TheDuckFrederik/Trafik/SCR-20260928-qmtm.jpeg

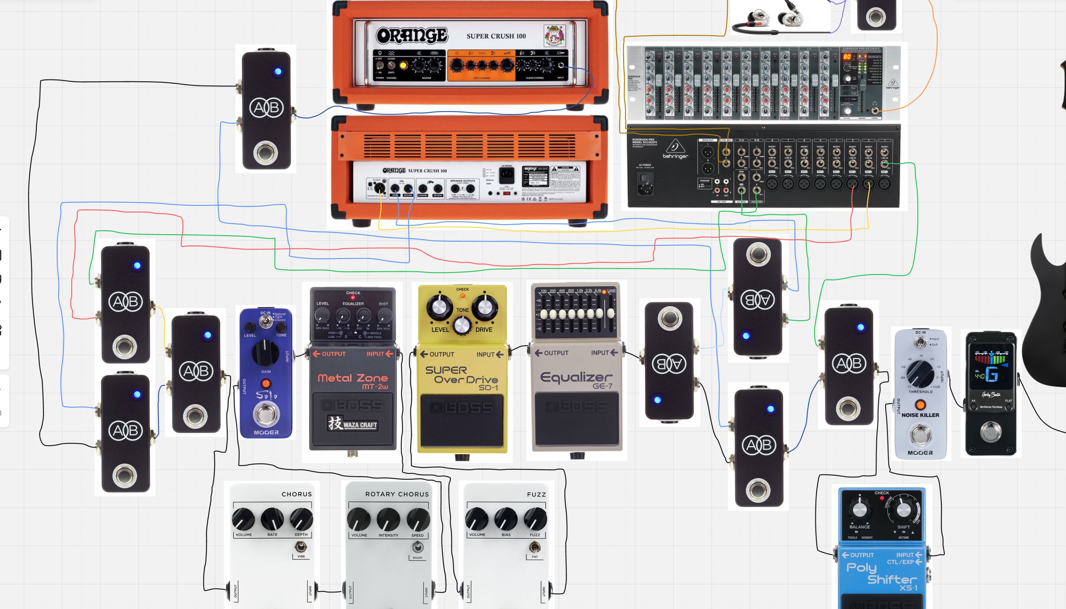
SCR-20260928-qmtm.jpeg
