TheDuckFrederik/Trafik/SCR-20260928-qmrf.jpeg

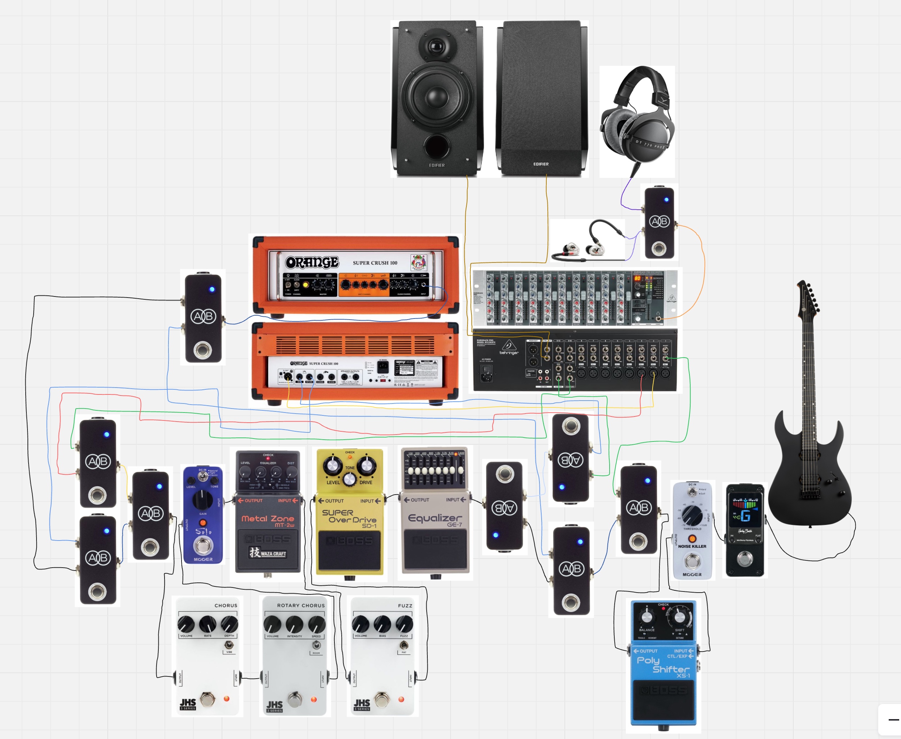
SCR-20260928-qmrf.jpeg
