TheDuckFrederik/Trafik/SingleLane/SingleLane.kicad_sch

## KiCad design SingleLane/SingleLane.kicad_sch (2026-10-13)

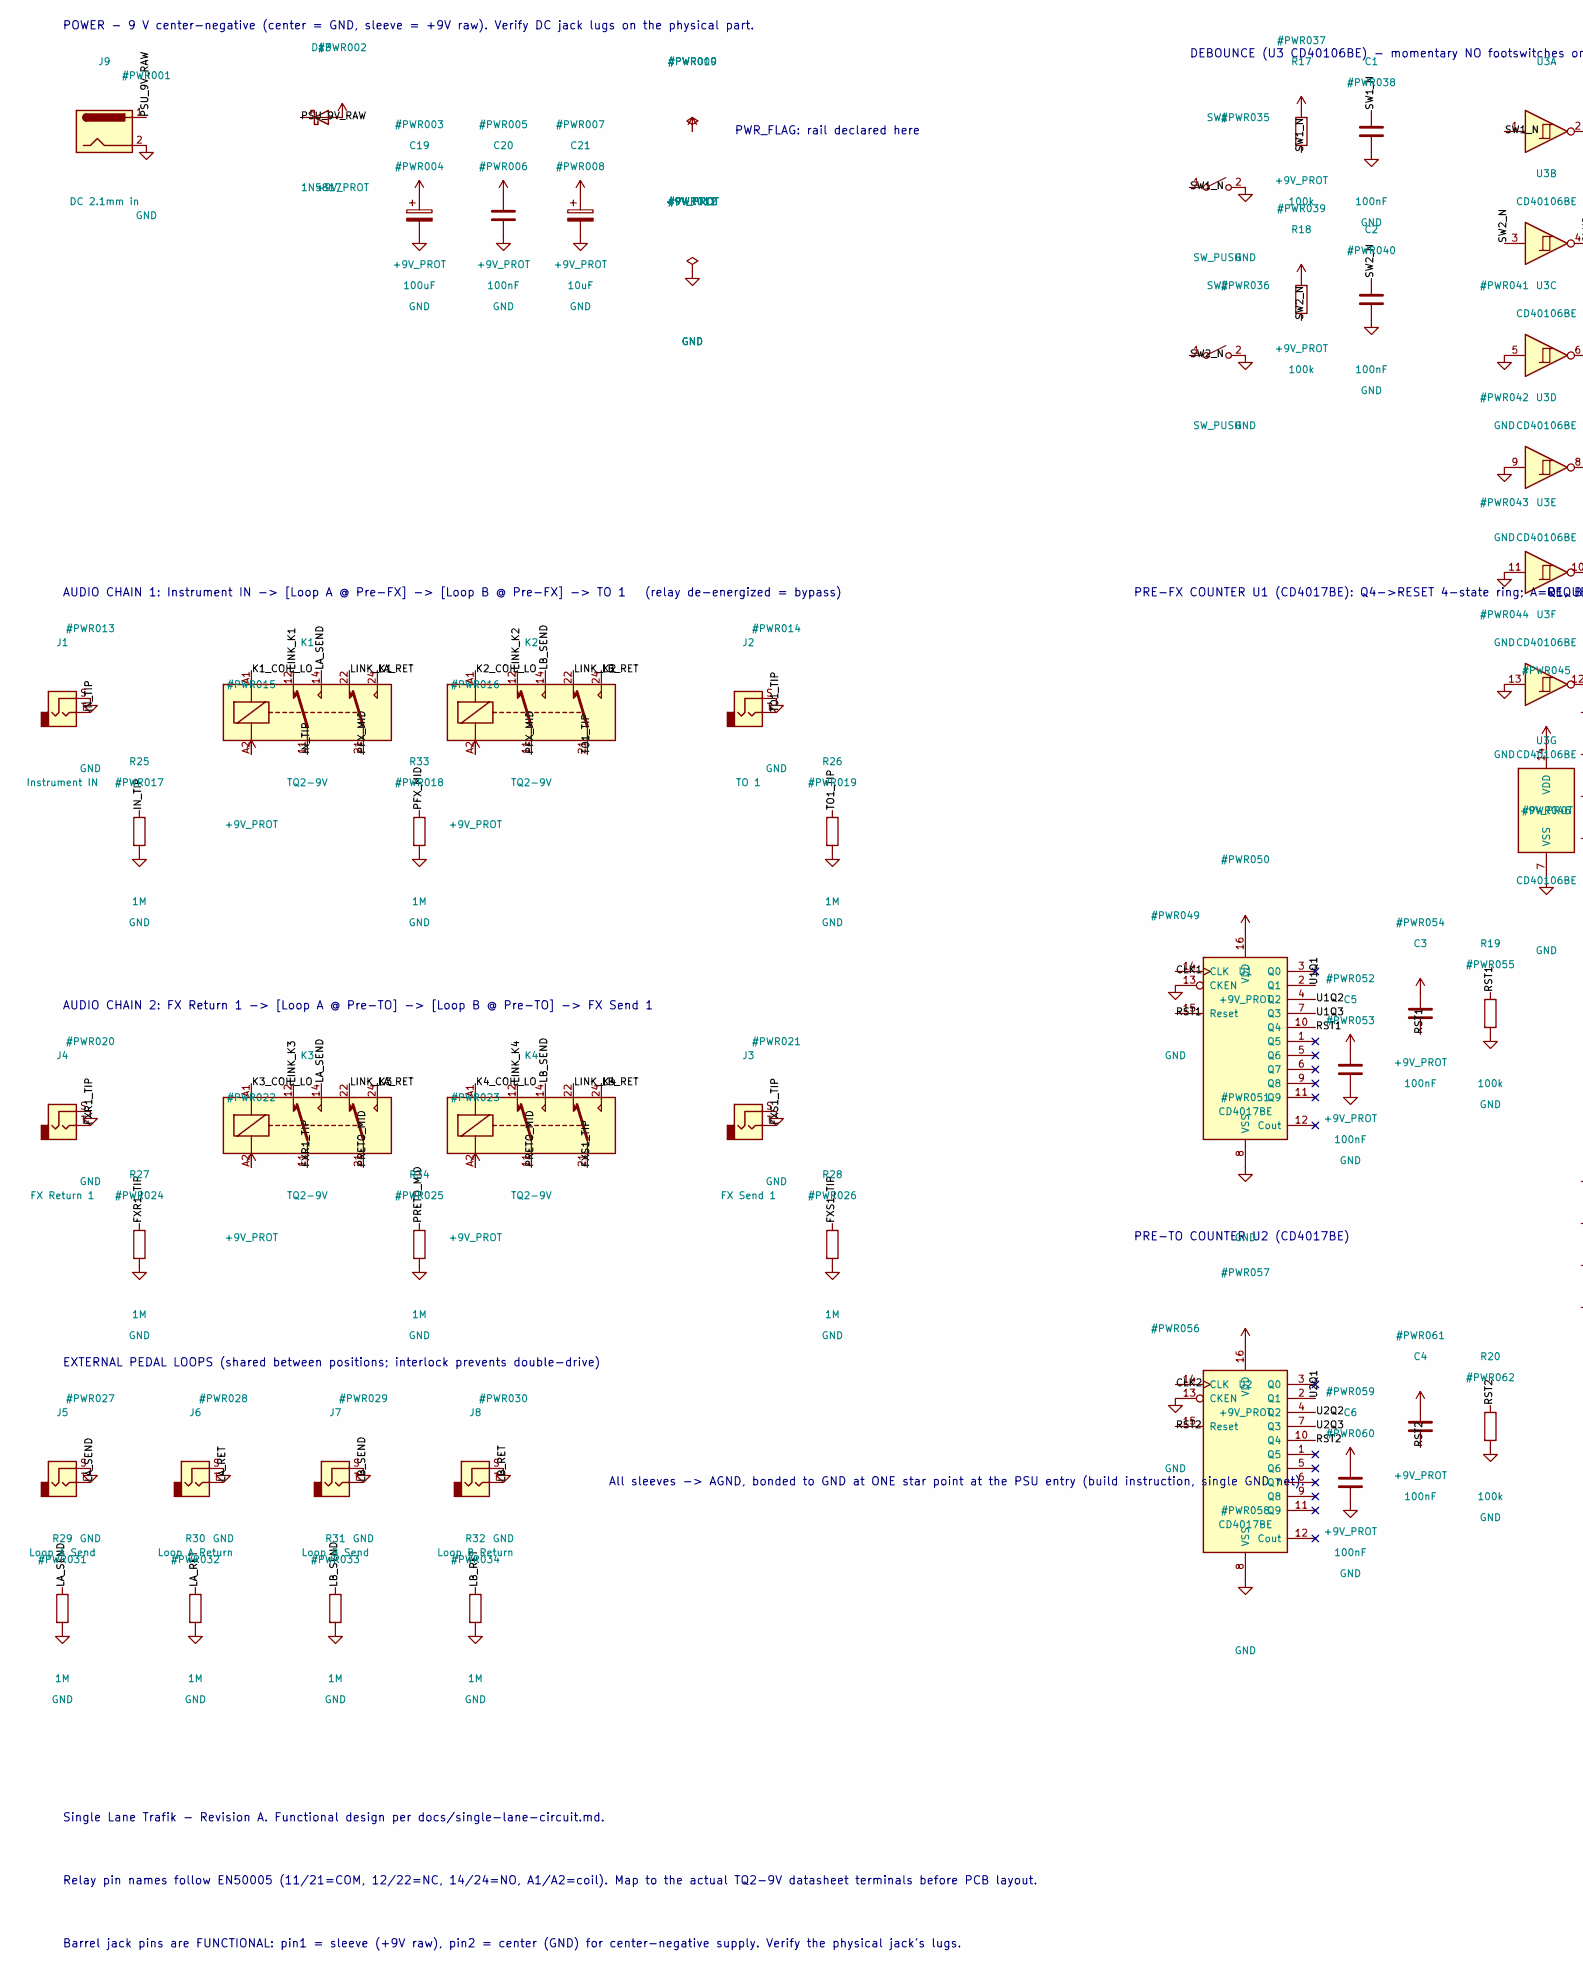
[picture p3: schematic SingleLane.kicad_sch, part in row 1, column 1]

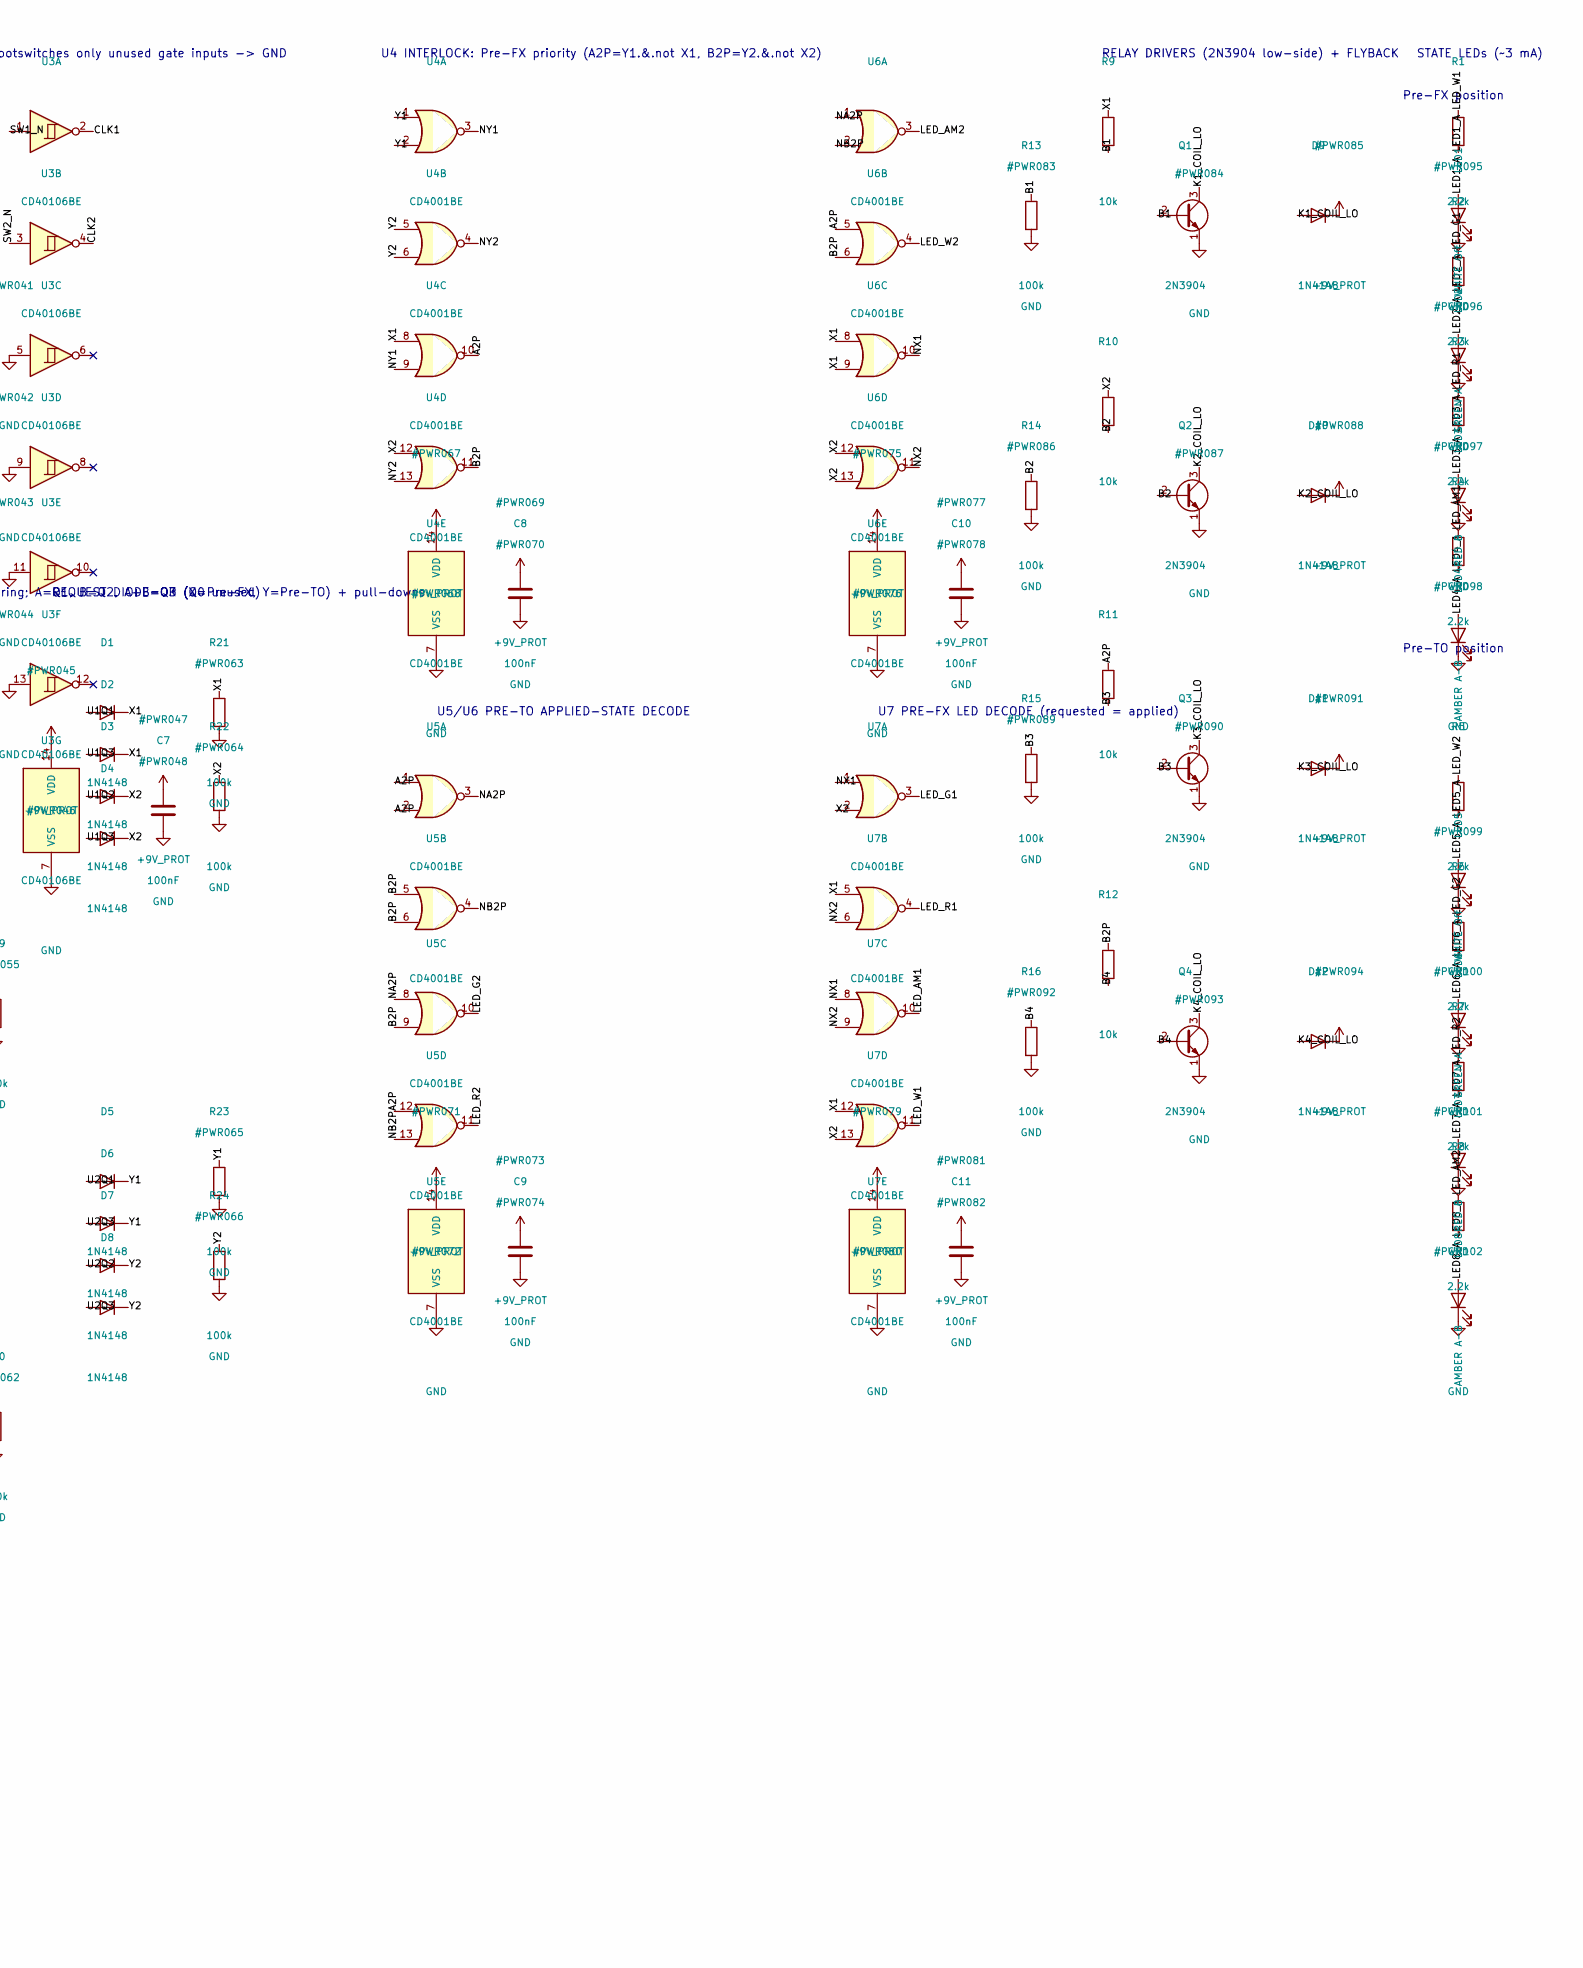
[picture p4: schematic SingleLane.kicad_sch, part in row 1, column 2]

Parts:
C1, C2, C3, C4, C5, C6, C7, C8, C9, C10, C11, C20: 100nF
C19: 100uF
C21: 10uF
D1, D2, D3, D4, D5, D6, D7, D8, D9, D10, D11, D12: 1N4148
D13: 1N5817
J1: Instrument IN
J2: TO 1
J3: FX Send 1
J4: FX Return 1
J5: Loop A Send
J6: Loop A Return
J7: Loop B Send
J8: Loop B Return
J9: DC 2.1mm in
K1, K2, K3, K4: TQ2-9V
LED1, LED5: WHITE Off
LED2, LED6: GREEN A
LED3, LED7: RED B
LED4, LED8: AMBER A-B
Q1, Q2, Q3, Q4: 2N3904
R1, R2, R3, R4, R5, R6, R7, R8: 2.2k
R9, R10, R11, R12: 10k
R13, R14, R15, R16, R17, R18, R19, R20, R21, R22, R23, R24: 100k
R25, R26, R27, R28, R29, R30, R31, R32, R33, R34: 1M
SW1, SW2: SW_PUSH
U1, U2: CD4017BE
U3: CD40106BE
U4, U5, U6, U7: CD4001BE

Connections:
+9V_PROT: C3.1, C4.1, C5.1, C6.1, C7.1, C8.1, C9.1, C10.1, C11.1, C19.1, C20.1, C21.1, D9.1 (K), D10.1 (K), D11.1 (K), D12.1 (K), D13.2 (A), K1.A2, K2.A2, K3.A2, K4.A2, R17.1, R18.1, U1.16 (VDD), U2.16 (VDD), U3.14 (VDD), U4.14 (VDD), U5.14 (VDD), U6.14 (VDD), U7.14 (VDD)
A2P: R11.1, U4.10, U5.1, U5.2, U5.12, U6.5
B1: Q1.2 (B), R9.2, R13.1
B2: Q2.2 (B), R10.2, R14.1
B2P: R12.1, U4.11, U5.5, U5.6, U5.9, U6.6
B3: Q3.2 (B), R11.2, R15.1
B4: Q4.2 (B), R12.2, R16.1
CLK1: U1.14 (CLK), U3.2
CLK2: U2.14 (CLK), U3.4
FXR1_TIP: J4.T, K3.11, R27.1
FXS1_TIP: J3.T, K4.21, R28.1
GND: C1.2, C2.2, C5.2, C6.2, C7.2, C8.2, C9.2, C10.2, C11.2, C19.2, C20.2, C21.2, J1.S, J2.S, J3.S, J4.S, J5.S, J6.S, J7.S, J8.S, J9.2, LED1.1 (K), LED2.1 (K), LED3.1 (K), LED4.1 (K), LED5.1 (K), LED6.1 (K), LED7.1 (K), LED8.1 (K), Q1.1 (E), Q2.1 (E), Q3.1 (E), Q4.1 (E), R13.2, R14.2, R15.2, R16.2, R19.2, R20.2, R21.2, R22.2, R23.2, R24.2, R25.2, R26.2, R27.2, R28.2, R29.2, R30.2, R31.2, R32.2, R33.2, R34.2, SW1.2 (B), SW2.2 (B), U1.8 (VSS), U1.13 (CKEN), U2.8 (VSS), U2.13 (CKEN), U3.5, U3.7 (VSS), U3.9, U3.11, U3.13, U4.7 (VSS), U5.7 (VSS), U6.7 (VSS), U7.7 (VSS)
IN_TIP: J1.T, K1.11, R25.1
K1_COIL_LO: D9.2 (A), K1.A1, Q1.3 (C)
K2_COIL_LO: D10.2 (A), K2.A1, Q2.3 (C)
K3_COIL_LO: D11.2 (A), K3.A1, Q3.3 (C)
K4_COIL_LO: D12.2 (A), K4.A1, Q4.3 (C)
LA_RET: J6.T, K1.24, K3.24, R30.1
LA_SEND: J5.T, K1.14, K3.14, R29.1
LB_RET: J8.T, K2.24, K4.24, R32.1
LB_SEND: J7.T, K2.14, K4.14, R31.1
LED1_A: LED1.2 (A), R1.2
LED2_A: LED2.2 (A), R2.2
LED3_A: LED3.2 (A), R3.2
LED4_A: LED4.2 (A), R4.2
LED5_A: LED5.2 (A), R5.2
LED6_A: LED6.2 (A), R6.2
LED7_A: LED7.2 (A), R7.2
LED8_A: LED8.2 (A), R8.2
LED_AM1: R4.1, U7.10
LED_AM2: R8.1, U6.3
LED_G1: R2.1, U7.3
LED_G2: R6.1, U5.10
LED_R1: R3.1, U7.4
LED_R2: R7.1, U5.11
LED_W1: R1.1, U7.11
LED_W2: R5.1, U6.4
LINK_K1: K1.12, K1.22
LINK_K2: K2.12, K2.22
LINK_K3: K3.12, K3.22
LINK_K4: K4.12, K4.22
NA2P: U5.3, U5.8, U6.1
NB2P: U5.4, U5.13, U6.2
NX1: U6.10, U7.1, U7.8
NX2: U6.11, U7.6, U7.9
NY1: U4.3, U4.9
NY2: U4.4, U4.13
PFX_MID: K1.21, K2.11, R33.1
PRETO_MID: K3.21, K4.11, R34.1
PSU_9V_RAW: D13.1 (K), J9.1
RST1: C3.2, R19.1, U1.10 (Q4), U1.15 (Reset)
RST2: C4.2, R20.1, U2.10 (Q4), U2.15 (Reset)
SW1_N: C1.1, R17.2, SW1.1 (A), U3.1
SW2_N: C2.1, R18.2, SW2.1 (A), U3.3
TO1_TIP: J2.T, K2.21, R26.1
U1Q1: D1.2 (A), U1.2 (Q1)
U1Q2: D3.2 (A), U1.4 (Q2)
U1Q3: D2.2 (A), D4.2 (A), U1.7 (Q3)
U2Q1: D5.2 (A), U2.2 (Q1)
U2Q2: D7.2 (A), U2.4 (Q2)
U2Q3: D6.2 (A), D8.2 (A), U2.7 (Q3)
X1: D1.1 (K), D2.1 (K), R9.1, R21.1, U4.8, U6.8, U6.9, U7.5, U7.12
X2: D3.1 (K), D4.1 (K), R10.1, R22.1, U4.12, U6.12, U6.13, U7.2, U7.13
Y1: D5.1 (K), D6.1 (K), R23.1, U4.1, U4.2
Y2: D7.1 (K), D8.1 (K), R24.1, U4.5, U4.6

Notes on the sheet:
POWER - 9 V center-negative (center = GND, sleeve = +9V raw). Verify DC jack lugs on the physical part.
PWR_FLAG: rail declared here
AUDIO CHAIN 1: Instrument IN -> [Loop A @ Pre-FX] -> [Loop B @ Pre-FX] -> TO 1 (relay de-energized = bypass)
AUDIO CHAIN 2: FX Return 1 -> [Loop A @ Pre-TO] -> [Loop B @ Pre-TO] -> FX Send 1
EXTERNAL PEDAL LOOPS (shared between positions; interlock prevents double-drive)
All sleeves -> AGND, bonded to GND at ONE star point at the PSU entry (build instruction, single GND net).
DEBOUNCE (U3 CD40106BE) - momentary NO footswitches only
unused gate inputs -> GND
PRE-FX COUNTER U1 (CD4017BE): Q4->RESET 4-state ring; A=Q1, B=Q2, A+B=Q3 (Q0 unused)
PRE-TO COUNTER U2 (CD4017BE)
REQUEST DIODE-OR (X=Pre-FX, Y=Pre-TO) + pull-downs
U4 INTERLOCK: Pre-FX priority (A2P=Y1.&.not X1, B2P=Y2.&.not X2)
U5/U6 PRE-TO APPLIED-STATE DECODE
U7 PRE-FX LED DECODE (requested = applied)
RELAY DRIVERS (2N3904 low-side) + FLYBACK
STATE LEDs (~3 mA)
Pre-FX position
Pre-TO position
Single Lane Trafik - Revision A. Functional design per docs/single-lane-circuit.md.
Relay pin names follow EN50005 (11/21=COM, 12/22=NC, 14/24=NO, A1/A2=coil). Map to the actual TQ2-9V datasheet terminals before PCB layout.
Barrel jack pins are FUNCTIONAL: pin1 = sleeve (+9V raw), pin2 = center (GND) for center-negative supply. Verify the physical jack's lugs.
