TheDuckFrederik/Trafik/(commit log)

2026-09-30 Add circuit design and electronics reference docs for all Trafik variants
2026-09-30 Clarify common Trafik circuit architecture
2026-09-30 Document single-loop prototype circuit
2026-10-01 Fix SVG layout overlaps and add ASCII wiring diagram reference
2026-10-01 Clarify TL072 follower annotation pin naming
